usevolt/icu/ce_mark_icu.pdf

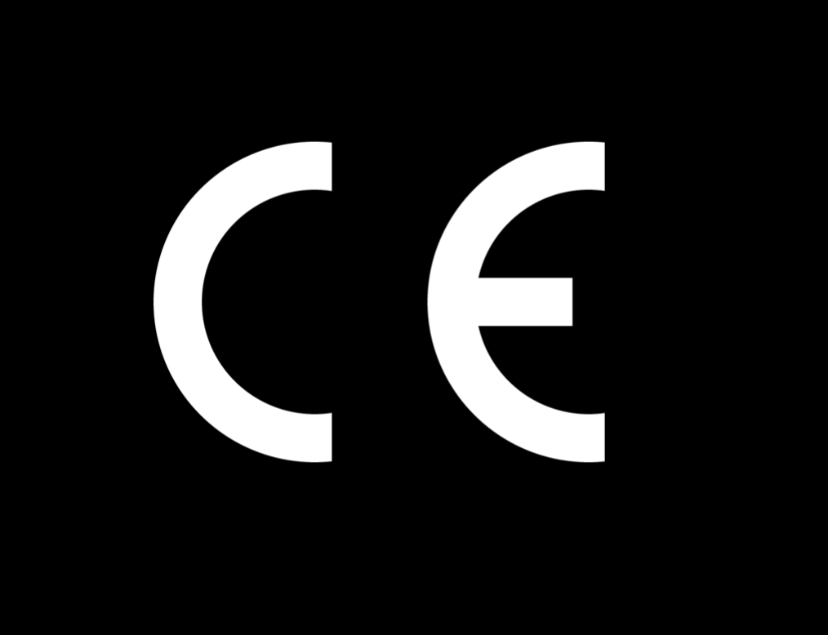
[picture p1: figure]

www.usewood.fi

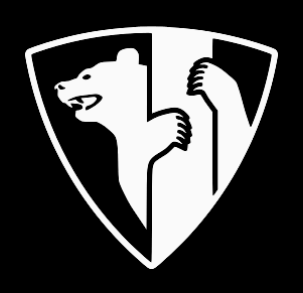
[picture p2: figure]

# Usewood ICU
