usevolt/icu/ce_mark_icu_55x20mm.png

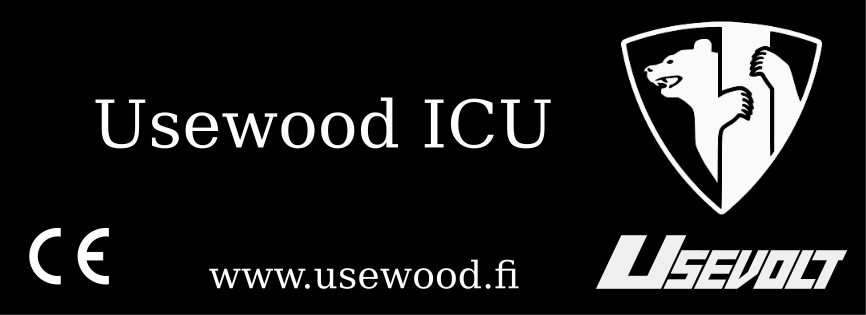
ce_mark_icu_55x20mm.png
