usevolt/icu/hw/board_outline.dxf

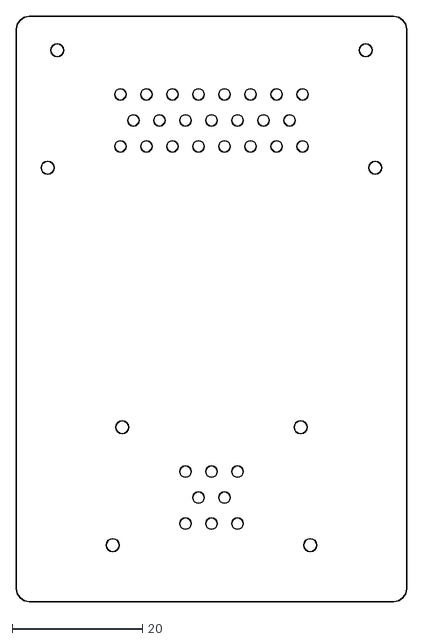
[picture p4: CAD file, 2018-05-06]
hw/board_outline.dxf
60.0 x 90.0
