usevolt/icu/hw/icu.FCStd

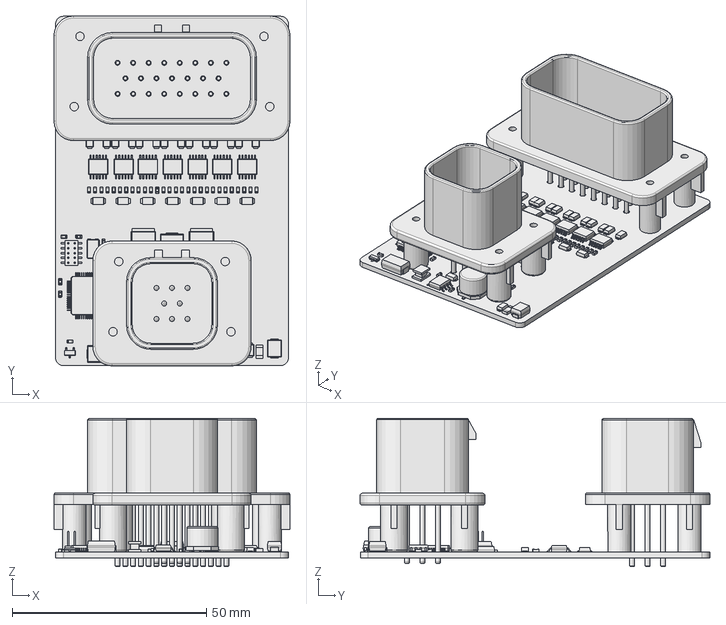
[picture p5: CAD file, 2018-02-19]
hw/icu.FCStd
60.8 x 90.2 x 38.2 mm
