usevolt/icu/hw/enclosure_bottom.fcstd

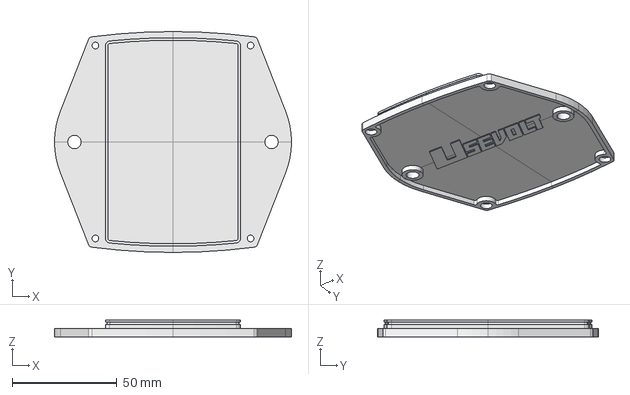
[picture p6: CAD file, 2018-02-19]
hw/enclosure_bottom.fcstd
113.0 x 105.3 x 8.00 mm
