usevolt/icu/hw/enclosure_top.stl

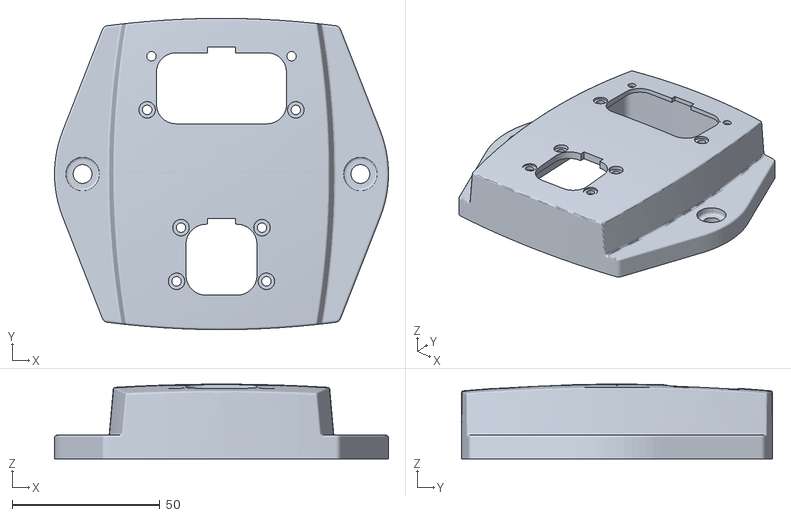
[picture p7: CAD file, 2018-02-19]
hw/enclosure_top.stl
113.0 x 105.3 x 25.3
