usevolt/icu/(list of files, cad)

Other CAD files:
hw/enclosure_bottom.stl
