usevolt/icu/hw/icu.kicad_pcb

## KiCad design hw/icu.kicad_pcb (2020-04-29)

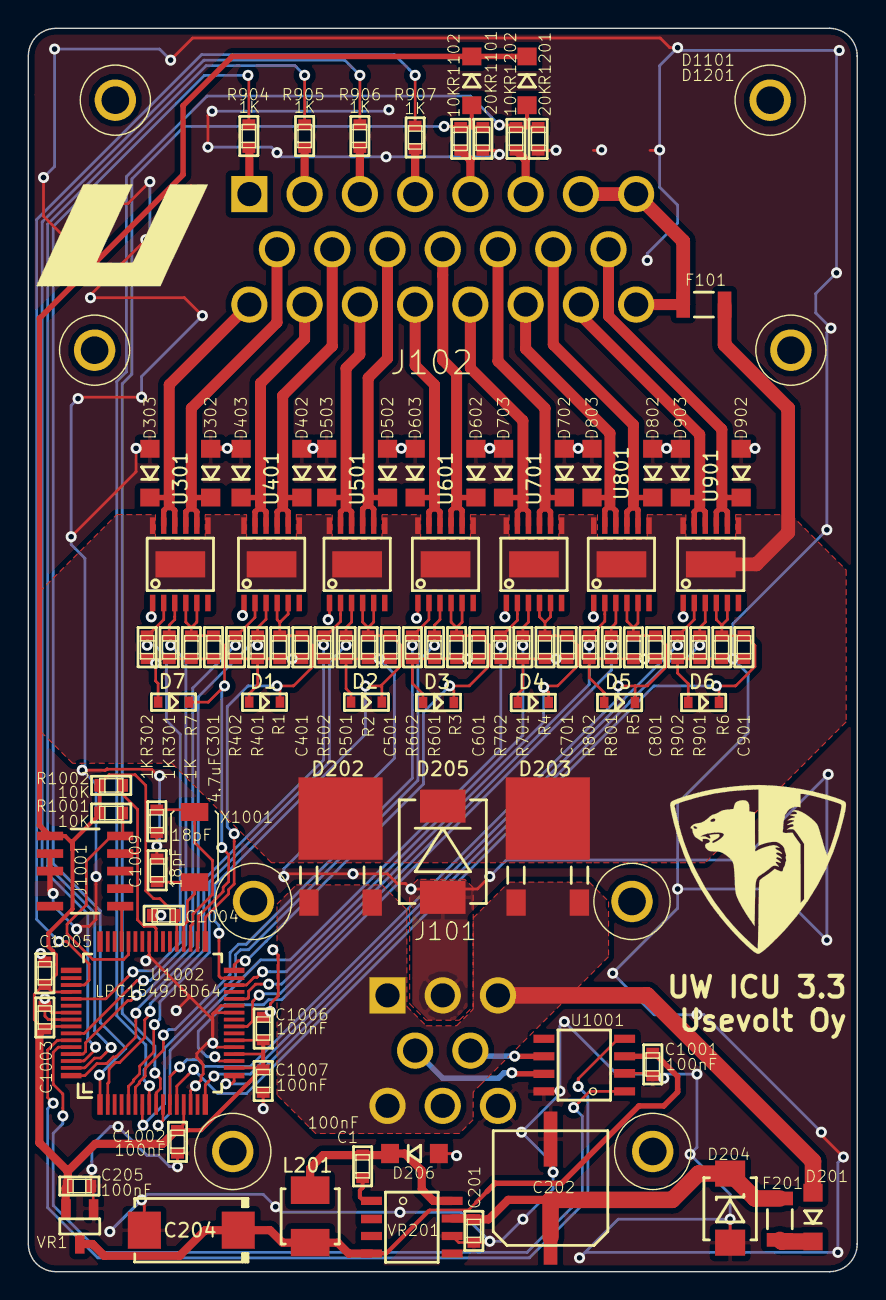
[picture p8: board icu.kicad_pcb from above]

Board: 2 copper layers, 60.0 x 90.0 mm, 99 parts (0 on the bottom side), 66 nets.

Parts:
C1, C201, C205, C1001, C1002, C1003, C1004, C1005, C1006, C1007: 100nF; 0603
C202: CAP_EEE-FK1H470P
C204: T491D226K035AT; 7343
C301, C401, C501, C601, C701, C801, C901: 4.7uF; 0603
C1008, C1009: 18pF; 0603
D1, D2, D3, D4, D5, D6, D7: ZENER_MM3Z3V6T1G; SOD-323
D201, D206, D302, D303, D402, D403, D502, D503, D602, D603, D702, D703, D802, D803, D902, D903, D1101, D1201: DIODE_RS07J-GS18; DO219AB
D202, D203: SCHOTTKY_DIODE_V40PW10C; SlimDPAK
D204: DIODE_TVS_SMBJ33A-TRDO-214AA; DO-214AA
D205: DIODE_TVS_TPSMD28A; DO-214AB
F101, F201: FUSE_MC36211_350MA; FUSE_MC36211
J101: AMPSEAL_8_POS_VERT_BLACK_SEALED_1-776276-1; AMPSEAL_8_POS_776275-1
J102: AMPSEAL_23_POS_VERT_GRAY_SEALED_1-776228-4; AMPSEAL_23_POS_776200-1
J1001: ARM_JTAG_SWD_HEADER_10_PINSMD; ARM_10_PIN_JTAG_SWD_CONNECTOR
L201: IND_744045210
R1, R2, R3, R4, R5, R6, R7, R301, R302, R401, R402, R501, R502, R601, R602, R701, R702, R801, R802, R901, R902, R904, R905, R906, R907: 1K; 0603
R1001, R1002, R1101, R1201: 10K; 0603
R1102, R1202: 20K; 0603
U301, U401, U501, U601, U701, U801, U901: VND5050AJTR-E; PowerSSO-12
U1001: MCP2551_SOIC8; SOIC8
U1002: LPC1549JBD64; QFP64
VR1: REG_MCP1700; SOT-23_3-PIN
VR201: LM2671SOIC8; SOIC8
X1001: XTAL_7A-12.000MAAJ-T; XTAL_7A-20.000MAJ

Connections:
+3V3: C205.1, C1002.1, C1003.1, C1004.1, C1005.1, C1006.1, C1007.1, D1101.P$2, D1201.P$2, J1001.P$1, R1001.2, R1002.2, U1002.P$13, U1002.P$18, U1002.P$20, U1002.P$22, U1002.P$37, U1002.P$52, U1002.P$57, VR1.2
+5V: C204.+, C1001.1, L201.2, U1001.3, VR1.3, VR201.4
/Power supply/VIN: D201.P$1, D202.1, D202.2, D203.1, D203.2, J101.1, J101.3, J101.6
/SENSORVDD_OUT: F101.P$2, J102.7, J102.8, J102.23
/Sheet5A7B2C1A/IN1: R401.2, U401.3, U1002.P$64
/Sheet5A7B2C1A/IN2: R402.2, U401.2, U1002.P$61
/Sheet5A7B2C1A/OUT1: D402.P$2, J102.10, U401.8, U401.9
/Sheet5A7B2C1A/OUT2: D403.P$2, J102.17, U401.10, U401.11
/Sheet5A7B3FAC/IN1: R601.2, U601.3, U1002.P$7
/Sheet5A7B3FAC/IN2: R602.2, U601.2, U1002.P$6
/Sheet5A7B3FAC/OUT1: D602.P$2, J102.12, U601.8, U601.9
/Sheet5A7B3FAC/OUT2: D603.P$2, J102.19, U601.10, U601.11
/Sheet5A7B4C12/IN1: R701.2, U701.3, U1002.P$30
/Sheet5A7B4C12/IN2: R702.2, U701.2, U1002.P$10
/Sheet5A7B4C12/OUT1: D702.P$2, J102.13, U701.8, U701.9
/Sheet5A7B4C12/OUT2: D703.P$2, J102.20, U701.10, U701.11
/Sheet5A7B341A/IN1: R501.2, U501.3, U1002.P$5
/Sheet5A7B341A/IN2: R502.2, U501.2, U1002.P$2
/Sheet5A7B341A/OUT1: D502.P$2, J102.11, U501.8, U501.9
/Sheet5A7B341A/OUT2: D503.P$2, J102.18, U501.10, U501.11
/Sheet5A7B577D/IN1: R801.2, U801.3, U1002.P$19
/Sheet5A7B577D/IN2: R802.2, U801.2, U1002.P$24
/Sheet5A7B577D/OUT1: D802.P$2, J102.14, U801.8, U801.9
/Sheet5A7B577D/OUT2: D803.P$2, J102.21, U801.10, U801.11
/Sheet5A7B753C/IN1: R901.2, U901.3, U1002.P$17
/Sheet5A7B753C/IN2: R902.2, U901.2, U1002.P$16
/Sheet5A7B753C/OUT1: D902.P$2, J102.15, U901.8, U901.9
/Sheet5A7B753C/OUT2: D903.P$2, J102.22, U901.10, U901.11
/Sheet5A7B1579/IN1: R301.2, U301.3, U1002.P$58
/Sheet5A7B1579/IN2: R302.2, U301.2, U1002.P$53
/Sheet5A7B1579/OUT1: D302.P$2, J102.9, U301.8, U301.9
/Sheet5A7B1579/OUT2: D303.P$2, J102.16, U301.10, U301.11
/Sheet5A7E2A6D/VIN: J102.6, R1201.2
/Sheet5A7E031D/VIN: J102.5, R1101.2
/lpc1549/AIN1: D1101.P$1, R1101.1, R1102.2, U1002.P$9
/lpc1549/AIN2: D1201.P$1, R1201.1, R1202.2, U1002.P$8
/lpc1549/CANH: J101.4, U1001.7
/lpc1549/CANL: J101.5, U1001.6
/lpc1549/CAN_RX: U1001.4, U1002.P$59
/lpc1549/CAN_TX: U1001.1, U1002.P$60
/lpc1549/DIN1: J102.1, R904.2
/lpc1549/DIN2: J102.2, R905.2
/lpc1549/DIN3: J102.3, R906.2
/lpc1549/DIN4: J102.4, R907.1
/lpc1549/OUT1_SENSE: C301.2, D7.1, R7.1, U301.4, U301.5, U1002.P$34
/lpc1549/OUT2_SENSE: C401.2, D1.1, R1.1, U401.4, U401.5, U1002.P$33
/lpc1549/OUT3_SENSE: C501.2, D2.1, R2.1, U501.4, U501.5, U1002.P$31
/lpc1549/OUT4_SENSE: C601.2, D3.1, R3.1, U601.4, U601.5, U1002.P$32
/lpc1549/OUT5_SENSE: C701.2, D4.1, R4.1, U701.4, U701.5, U1002.P$28
/lpc1549/OUT6_SENSE: C801.2, D5.1, R5.1, U801.4, U801.5, U1002.P$11
/lpc1549/OUT7_SENSE: C901.2, D6.1, R6.1, U901.4, U901.5, U1002.P$12
/lpc1549/RESET: J1001.P$9, U1002.P$45
GND: C201.2, C202.-, C204.-, C205.2, C301.1, C401.1, C501.1, C601.1, C701.1, C801.1, C901.1, C1001.2, C1002.2, C1003.2, C1004.2, C1005.2, C1006.2, C1007.2, C1008.2, C1009.2, D1.2, D2.2, D3.2, D4.2, D5.2, D6.2, D7.2, D204.P$1, D205.1, D206.P$1, D302.P$1, D303.P$1, D402.P$1, D403.P$1, D502.P$1, D503.P$1, D602.P$1, D603.P$1, D702.P$1, D703.P$1, D802.P$1, D803.P$1, D902.P$1, D903.P$1, J101.2, J101.8, J1001.P$3, J1001.P$5, R1.2, R2.2, R3.2, R4.2, R5.2, R6.2, R7.2, R301.1, R302.1, R401.1, R402.1, R501.1, R502.1, R601.1, R602.1, R701.1, R702.1, R801.1, R802.1, R901.1, R902.1, R1102.1, R1202.1, U301.1, U401.1, U501.1, U601.1, U701.1, U801.1, U901.1, U1001.2, U1001.8, U1002.P$14, U1002.P$21, U1002.P$26, U1002.P$27, U1002.P$41, U1002.P$55, U1002.P$56, VR1.1, VR201.6
unnamed: C1.1, D206.P$2, L201.1, VR201.8
unnamed: C1.2, VR201.1
unnamed: C201.1, C202.+, D204.P$2, F201.P$2, VR201.7
unnamed: C1008.1, U1002.P$35, X1001.P$1
unnamed: C1009.1, U1002.P$36, X1001.P$2
unnamed: D201.P$2, F201.P$1
unnamed: J1001.P$2, R1001.1, U1002.P$44
unnamed: J1001.P$4, R1002.1, U1002.P$40
unnamed: R904.1, U1002.P$1
unnamed: R905.1, U1002.P$63
unnamed: R906.1, U1002.P$62
unnamed: R907.2, U1002.P$51
VDD: D202.3, D203.3, D205.2, F101.P$1, U301.7, U301.12, U301.13, U401.7, U401.12, U401.13, U501.7, U501.12, U501.13, U601.7, U601.12, U601.13, U701.7, U701.12, U701.13, U801.7, U801.12, U801.13, U901.7, U901.12, U901.13
