usevolt/icu/sw/inc/remote_valve.h

/* 
 * This file is part of the uv_hal distribution (www.usevolt.fi).
 * Copyright (c) 2017 Usevolt Oy.
 * 
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
 * You should have received a copy of the GNU General Public License 
 * along with this program. If not, see <http://www.gnu.org/licenses/>.
*/


#ifndef REMOTE_VALVE_H_
#define REMOTE_VALVE_H_


#include <uv_utilities.h>


/// @file: Remote valve module is an hydraulic valve which is controlled over CAN-bus,
/// such as impl1 and impl2 valves supplying the oil flow to harvester head.


#define ICU_CONF_ACC_MAX	100
#define ICU_CONF_DEC_MAX	100
#define ICU_CONF_SPEED_MAX	100

/// @brief: Configuration module for general ICU modules.
typedef struct {
	// max speed in forward direction, from 0 ... 100
	uint16_t max_speed_a;
	uint16_t max_speed_b;
	uint16_t invert;
	// from 0 ... 100
	uint16_t acc;
	// from 0 ... 100
	uint16_t dec;
	uint16_t assembly_invert;
} icu_conf_st;


#include <uv_utilities.h>

typedef struct {
	bool drive_to_zero;
	bool stopped;
	uv_delay_st delay;
	uint16_t delay_time_ms;
	int8_t req;
	bool dual_dir;
	// stores the pointer of the requester. This pointer
	// is used as priority. If two or more requesters make a request
	// at the same time, the one with bigger priority wins.
	void *requester_priority_ptr;
} remote_valve_st;


void remote_valve_init(remote_valve_st *this, uint16_t delay_time_ms, bool dual_dir);


void remote_valve_step(remote_valve_st *this, uint16_t step_ms);


/// @brief: Sets the oil flow request in relative value. The request is accepted only if
/// the last request was zero or bigger than new one. The actual request is calculated with
/// scaled with **conf** parameters, if given.
void remote_valve_set_request(remote_valve_st *this,
		void *requester, int8_t request, icu_conf_st *conf);


static inline int8_t remote_valve_get_request(remote_valve_st *this) {
	return this->req;
}


void remote_valve_drive_to_zero(remote_valve_st *this);

/// @brief: Returns true after the **remote_valve_drive_to_zero** request has called and
/// the valve has driven itself to zero. Note that this returns true even if some normal request
/// sets the valve to non-zero again.
static inline bool remote_valve_is_zero(remote_valve_st *this) {
	return this->stopped;
}



#endif /* REMOTE_VALVE_H_ */
