usevolt/icu/sw/inc/input.h

/* 
 * This file is part of the uv_hal distribution (www.usevolt.fi).
 * Copyright (c) 2017 Usevolt Oy.
 * 
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
 * You should have received a copy of the GNU General Public License 
 * along with this program. If not, see <http://www.gnu.org/licenses/>.
*/


#ifndef INC_INPUT_H_
#define INC_INPUT_H_


#include <uv_utilities.h>
#include <uv_dual_output.h>
#include "remote_valve.h"


#define INPUT_MAX_REQ	INT8_MAX
#define INPUT_MIN_REQ	(INT8_MIN + 1)

/// @brief: Module which converts raw variable input into pressed, released, etc actions

/// @brief: If request was active for shorter time than this, consider it as a click
#define INPUT_CLICK_DELAY_MS			60
/// @brief: Value which has to be exceeded in order to produce a click
#define INPUT_CLICK_VALUE				100

typedef struct {
	int8_t request;

	int8_t last_request;

	bool pressed;
	bool released;
	bool clicked;

	bool click_possible;
	int32_t click_delay;

} input_st;


void input_init(input_st *this);

void input_step(input_st *this, uint16_t step_ms);

static inline bool input_pressed(input_st *this) {
	return this->pressed;
}

static inline bool input_released(input_st *this) {
	return this->released;
}

static inline bool input_clicked(input_st *this) {
	return this->clicked;
}

/// @brief: Returns the input request in scale of INT8_MIN ... INT8_MAX
static inline int8_t input_get_request(input_st *this, icu_conf_st *conf) {
	return this->request * ((conf->invert) ? -1 : 1);
}

uv_dual_output_dir_e input_get_dir(input_st *this, icu_conf_st *conf);

/// @brief: Returns the requested direction straight from request without input_st module
static inline uv_dual_output_dir_e input_get_dir_from_req(int8_t req) {
	input_st i;
	icu_conf_st conf;
	conf.invert = false;
	i.request = req;
	return input_get_dir(&i, &conf);
}

#endif /* INC_INPUT_H_ */
