usevolt/icu/(commit log)

2018-02-19 enclosure top & bottom ready to order
    [ain.sch, enclosure_bottom.fcstd, enclosure_bottom.stl, enclosure_top.stl, icu.FCStd, icu.kicad_pcb, icu.sch, lpc1549.sch]
2018-02-20 hw 1.0 ready to order
    [ain.sch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]
2018-05-06 050518: Kikepera head prototype first revision, saw not working
    [ain-2018-03-16-09-33-21.sch, ain-2018-03-20-20-34-22.sch, ain.sch, board_outline.dxf, icu-2018-03-16-09-33-21.sch, icu-2018-03-20-20-34-22.sch, icu.FCStd, icu.kicad_pcb]
2018-06-06 first working prototype in kikeperä
2018-06-09 analog inputs replaced with digital inputs
    [icu.kicad_pcb, icu.sch, lpc1549.sch, pwr_supply_sheet.sch, vnd5050.sch]
2018-07-07 pcb 2.0 created, with imu
    [icu-B.Cu.gbl, icu-B.Mask.gbs, icu-B.SilkS.gbo, icu-Edge.Cuts.gm1, icu-F.Cu.gtl, icu-F.Mask.gts, icu-F.SilkS.gto, icu.drl]
2018-08-12 2 din replaced with ain, zeners added to outputs
    [ain.sch, icu.kicad_pcb, icu.sch, imu.sch, lpc1549.sch, pwr_supply_sheet.sch, vnd5050.sch]
2018-09-07 implementing icu in CM_6.2.1
    [icu.sch]
2018-09-09 CM_6.2.1 delivered, first customer machine with CCU, HCU & ICU
    [ain.sch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]
2018-09-13 feed target reaching bug fixes
    [feed.c, messages.c]
2018-10-04 3.0.0 hw and gerber created
    [ain-2018-10-04-20-07-08.sch, ain.sch, icu-2018-10-04-20-07-08.sch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]
2018-10-04 hw 3.1 silkscreen modifications
    [icu-B.Cu.gbl, icu-B.Mask.gbs, icu-B.SilkS.gbo, icu-Edge.Cuts.gm1, icu-F.Cu.gtl, icu-F.Mask.gts, icu-F.SilkS.gto, icu-NPTH.drl]
2018-12-21 pcb 3.2.0 created, with 12V supply for sensors
    [icu-B.Cu.gbl, icu-B.Mask.gbs, icu-B.SilkS.gbo, icu-Edge.Cuts.gm1, icu-F.Cu.gtl, icu-F.Mask.gts, icu-F.Paste.gtp, icu-F.SilkS.gto]
2019-01-23 3.3 pcb created
    [ain.sch, icu.kicad_pcb, icu.sch, lpc1549.sch, pwr_supply_sheet.sch, vnd5050.sch]
2019-01-24 3.4.0 pcb created
    [icu-B.Cu.gbl, icu-B.Mask.gbs, icu-B.SilkS.gbo, icu-Edge.Cuts.gm1, icu-F.Cu.gtl, icu-F.Mask.gts, icu-F.SilkS.gto, icu-NPTH.drl]
2019-05-10 blades & feed open bugfix:
    Delay in keeping the valve open after the request has stopped dos not cause a delay when changing the allopen direction
    [bladeopen.c]
2019-09-10 allopen operates tilt also, tilt mapped to right keypad button 7
2019-10-10 vol measurement is added for all logs that have a positive length of 8cm or greater
2020-01-09 bugfix: all_open saw uses saw settings for speed settings
    [allopen.c]
2020-01-18 allopen tilt bugfix: uses tilt speed settings instead of saw
    [allopen.c, messages.c]
2020-04-29 small updates on schematic
    [icu.kicad_pcb]
2021-01-02 feed len inc reduced greatly for separate length meas wheel
